recepuysal/kicad-ai-battery-charger/hardware/bom.csv

Reference | Value | Footprint | LCSC | Qty | DNP
C1,C3,C4 | 22uF | LCSC:C0805 | C45783 | 3
C2,C6,C11,C12 | 10uF | LCSC:C0805 | C15850 | 4
C7,C16 | 100nF | LCSC:C0603 | C1591 | 2 | DNP
C8,C9,C10,C14 | 100nF | LCSC:C0603 | C1591 | 4
C15 | 1uF | LCSC:C0603 | C15849 | 1
D1,D2 | SS34 | LCSC:SMA_L4.2-W2.7-LS5.0-RD | C2837271 | 2
D3 | ESDA7P120 | LCSC:SGP1610N2_L1.6-W1.0-P1.1-RD | C2969802 | 1
F1 | 1.1A PTC | LCSC:F2920 | C6044766 | 1
J1 | B8B-XH-A | LCSC:CONN-TH_B8B-XH-A-LF-SN | C157972 | 1
J7 | PİL 3P | LCSC:CONN-TH_3P-P2.50_A2501WV2-3P | C144394 | 1
L2 | 10uH 4.5A | LCSC:IND-SMD_L7.3-W6.8 | C167223 | 1
Q1,Q5 | AO3401A | LCSC:SOT-23_L2.9-W1.3-P1.90-LS2.4-BR | C15127 | 2
Q3 | FS8205A | LCSC:SOT-23-6_L2.9-W1.6-P0.95-LS2.8-BR | C2830320 | 1 | DNP
R1 | 10k | LCSC:R0603 | C25804 | 1
R2,R3 | 5.1k | LCSC:R0603 | C23186 | 2
R4 | 75k | LCSC:R0603 | C23242 | 1
R5 | 100R | LCSC:R0603 | C22775 | 1 | DNP
R6,R11 | 15k | LCSC:R0603 | C22809 | 2
R7,R15,R19 | 100k | LCSC:R0603 | C25803 | 3
R8 | 1k | LCSC:R0603 | C21190 | 1 | DNP
R9 | 1.2k | LCSC:R0603 | C22765 | 1
R16,R17 | 22k | LCSC:R0603 | C31850 | 2
R18 | 6.2k | LCSC:R0603 | C4260 | 1
R20 | 150k | LCSC:R0603 | C22807 | 1
R21,R25 | 0R | LCSC:R0603 | C21189 | 2
R24 | 10k | LCSC:R0603 | C25804 | 1 | DNP
R22,R23 | 4.7k | LCSC:R0603 | C23162 | 2
SW2 | SS12D10G4 | LCSC:SW-TH_SHOU-HAN_SS12D10G4 | C2887259 | 1
TP1 | VBUS | TestPoint:TestPoint_Pad_D2.0mm |  | 1
TP2 | +5V | TestPoint:TestPoint_Pad_D2.0mm |  | 1
TP3 | +3V3 | TestPoint:TestPoint_Pad_D2.0mm |  | 1
TP4 | GND | TestPoint:TestPoint_Pad_D2.0mm |  | 1
TP5 | BAT+ | TestPoint:TestPoint_Pad_D2.0mm |  | 1
TP6 | PROG | TestPoint:TestPoint_Pad_D2.0mm |  | 1
U1 | MT3608 | LCSC:SOT-23-6_L2.9-W1.6-P0.95-LS2.8-BL | C84817 | 1
U2 | DW01A | LCSC:SOT-23-6_L2.9-W1.6-P0.95-LS2.8-BL | C351410 | 1 | DNP
U3 | MAX17048 | LCSC:TDFN-8_L2.0-W2.0-P0.50-BL-EP1.2 | C2682616 | 1
U6 | TP4056 | LCSC:ESOP-8_L4.9-W3.9-P1.27-LS6.0-BL-EP | C725790 | 1
U9 | AP2112K-3.3 | LCSC:SOT-25-5_L2.9-W1.6-P0.95-LS2.8-BL | C51118 | 1
USB1 | TYPE-C 6P | LCSC:TYPE-C-SMD_TYPE-C-6P-073 | C668623 | 1
