recepuysal/kicad-ai-battery-charger/docs/schematic.pdf

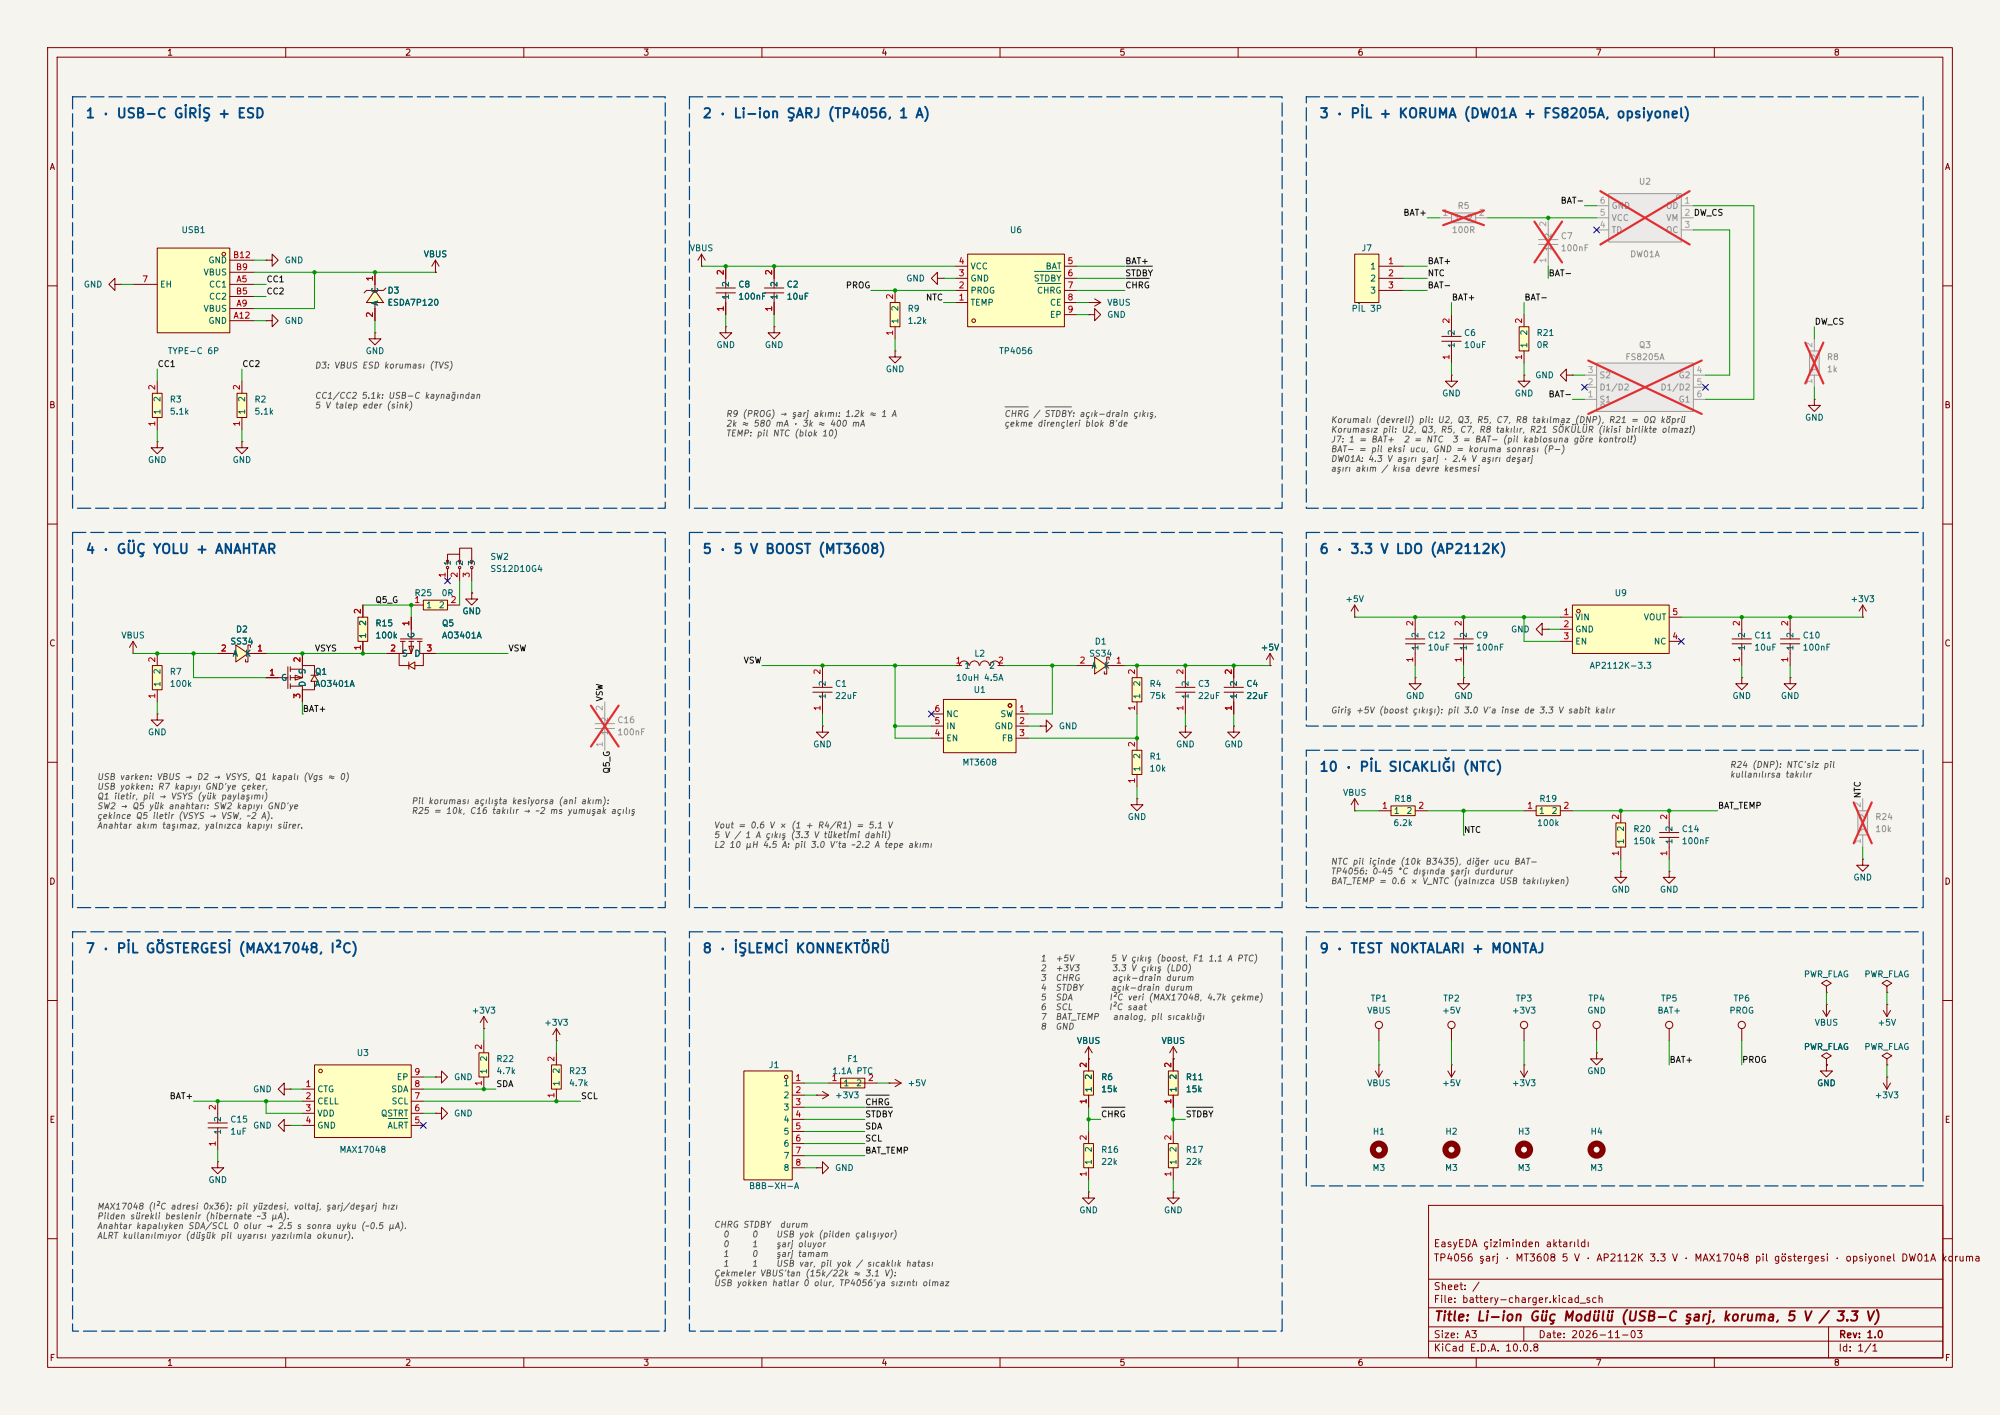
[picture p2: page 1]

CHRG / STDBY: açık-drain çıkış,

Giriş +5V (boost çıkışı): pil 3.0 V'a inse de 3.3 V sabit kalır Korumalı (devreli) pil: U2, Q3, R5, C7, R8 takılmaz (DNP), R21 = 0Ω köprü Korumasız pil: U2, Q3, R5, C7, R8 takılır, R21 SÖKÜLÜR (ikisi birlikte olmaz!) J7: 1 = BAT+ 2 = NTC 3 = BAT− (pil kablosuna göre kontrol!) BAT- = pil eksi ucu, GND = koruma sonrası (P-) DW01A: 4.3 V aşırı şarj · 2.4 V aşırı deşarj aşırı akım / kısa devre kesmesi

TEMP: pil NTC (blok 10)

USB varken: VBUS → D2 → VSYS, Q1 kapalı (Vgs ≈ 0) USB yokken: R7 kapıyı GND'ye çeker, Q1 iletir, pil → VSYS (yük paylaşımı) SW2 → Q5 yük anahtarı: SW2 kapıyı GND'ye

R24 (DNP): NTC'siz pil kullanılırsa takılır 8 · İŞLEMCİ KONNEKTÖRÜ

Vout = 0.6 V × (1 + R4/R1) = 5.1 V 5 V / 1 A çıkış (3.3 V tüketimi dahil) L2 10 µH 4.5 A: pil 3.0 V'ta ~2.2 A tepe akımı Pil koruması açılışta kesiyorsa (ani akım): R25 = 10k, C16 takılır → ~2 ms yumuşak açılış

çekince Q5 iletir (VSYS → VSW, ~2 A). Anahtar akım taşımaz, yalnızca kapıyı sürer.

NTC pil içinde (10k B3435), diğer ucu BAT−
TP4056: 0–45 °C dışında şarjı durdurur BAT_TEMP = 0.6 × V_NTC (yalnızca USB takılıyken)

MAX17048 (I²C adresi 0x36): pil yüzdesi, voltaj, şarj/deşarj hızı Pilden sürekli beslenir (hibernate ~3 µA). Anahtar kapalıyken SDA/SCL 0 olur → 2.5 s sonra uyku (~0.5 µA). ALRT kullanılmıyor (düşük pil uyarısı yazılımla okunur).

TP4056 şarj · MT3608 5 V · AP2112K 3.3 V · MAX17048 pil göstergesi · opsiyonel DW01A koruma

Sheet: /
File: battery-charger.kicad_sch
Title: Li-ion Güç Modülü (USB-C şarj, koruma, 5 V / 3.3 V)

Size: A3 | Rev: 1.0 | F Date: 2026-11-03
KiCad E.D.A. 10.0.8 | Id: 1/1
