recepuysal/kicad-ai-battery-charger/hardware/battery-charger.kicad_sch

## KiCad design hardware/battery-charger.kicad_sch (2026-11-03)

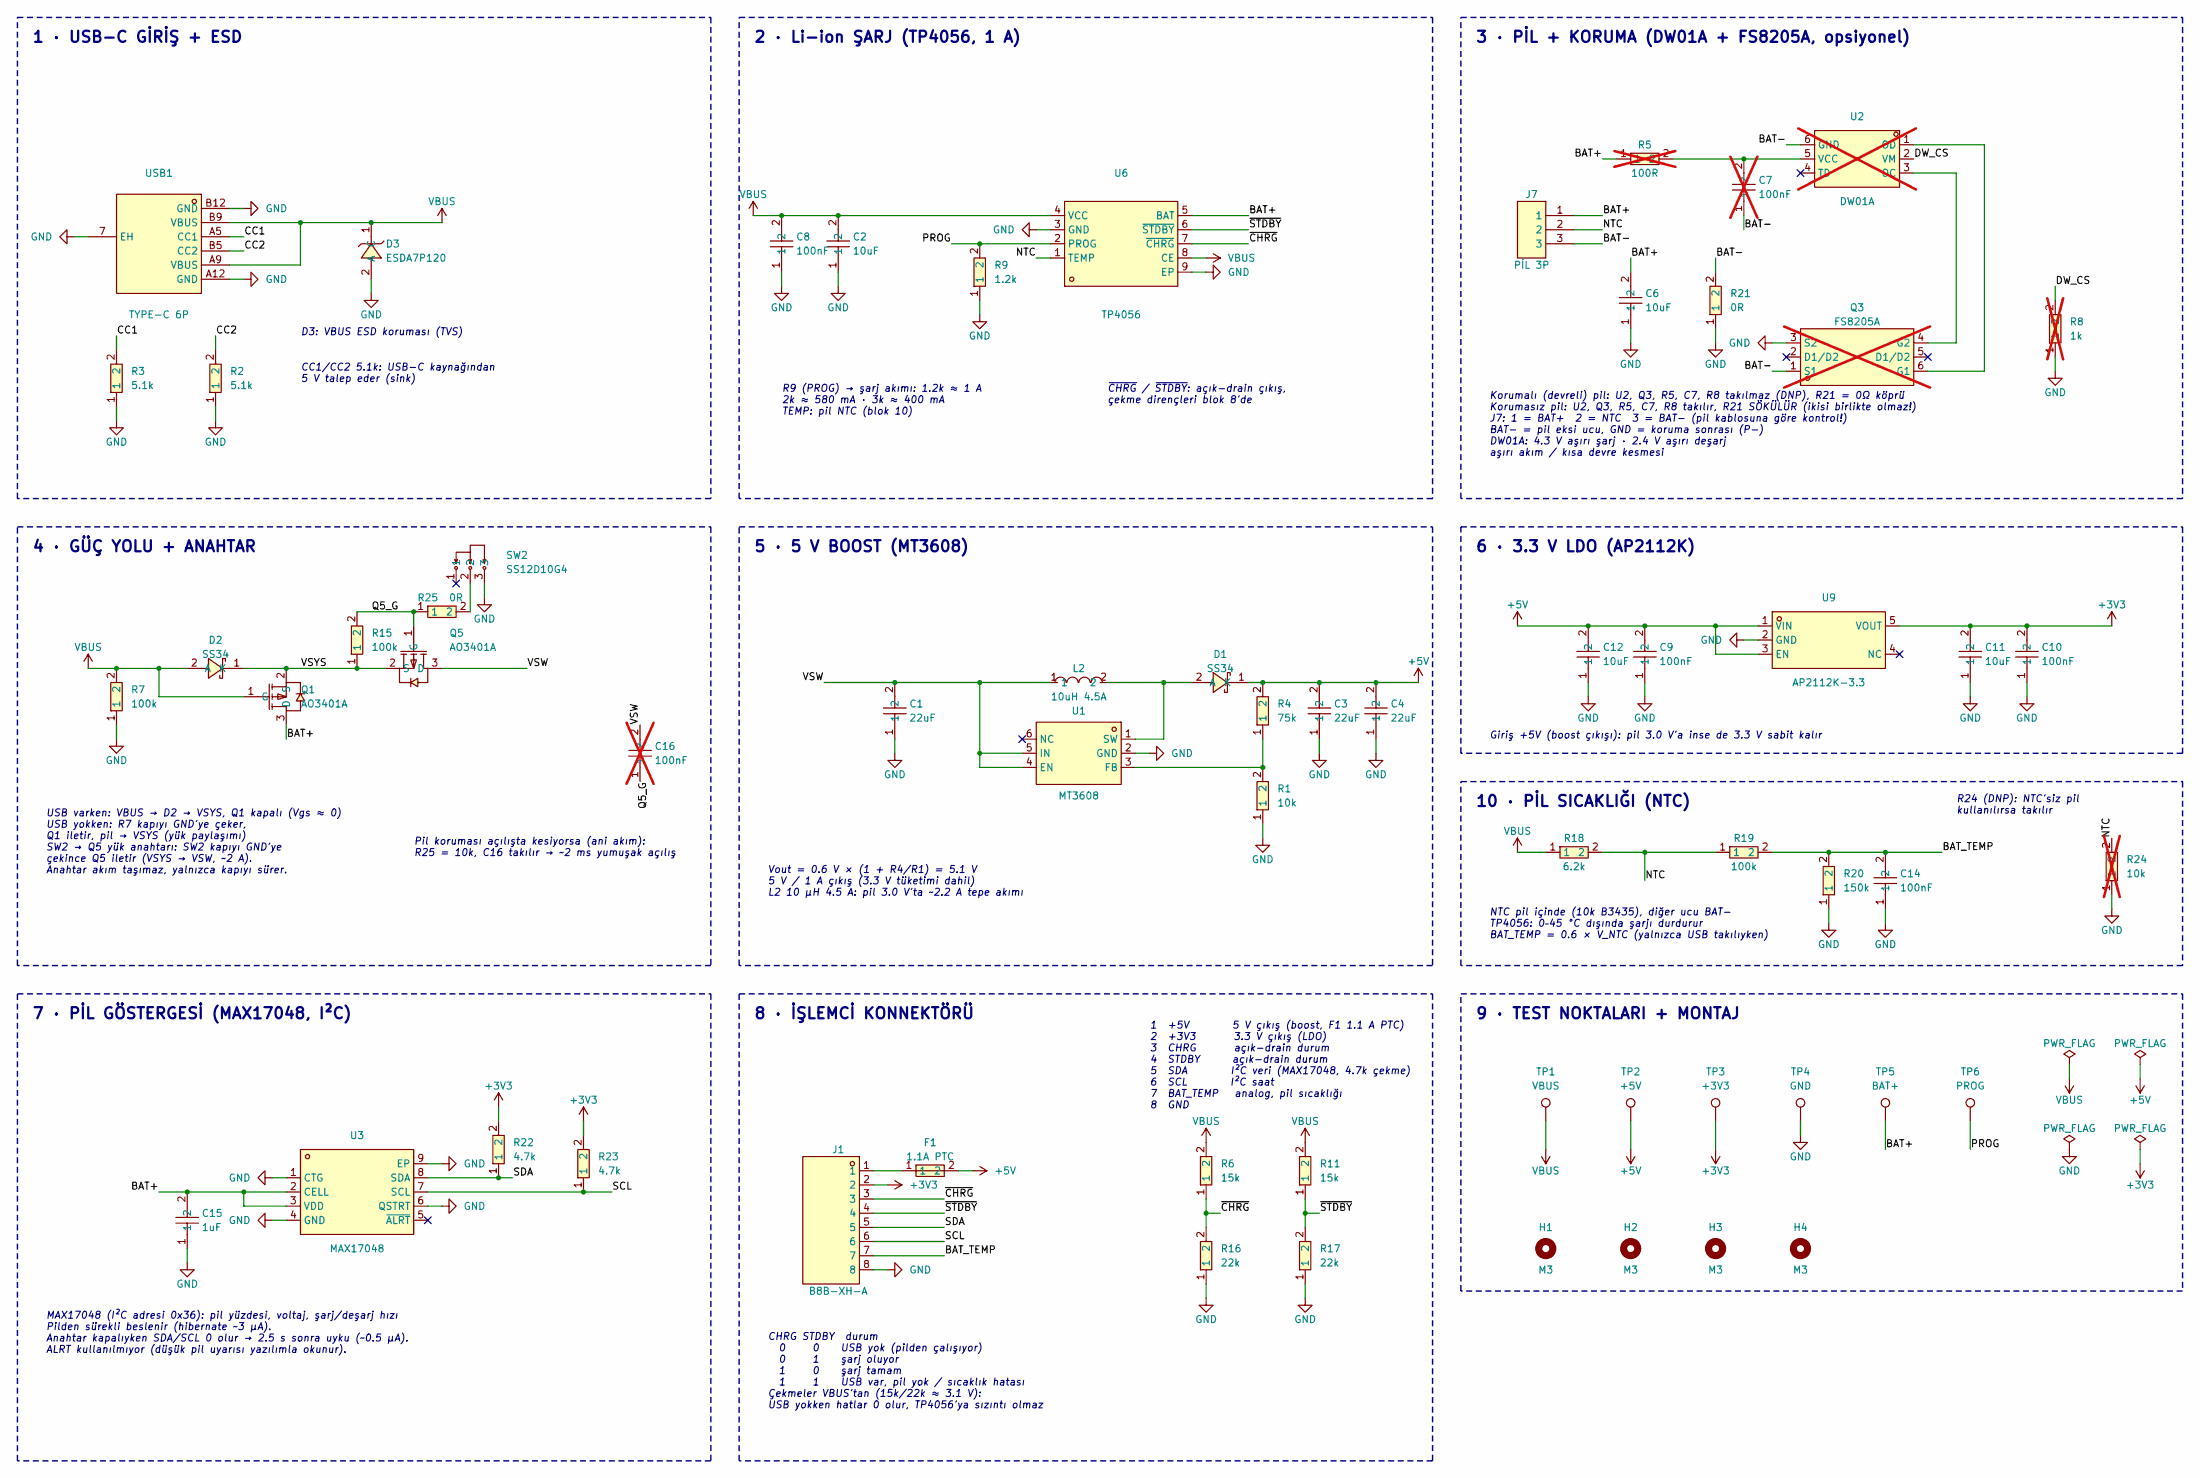
[picture p3: schematic battery-charger.kicad_sch]

Parts:
C1, C3, C4: 22uF; C0805; MPN CL21A226MAQNNNE; LCSC Part C45783
C2, C6, C11, C12: 10uF; C0805; MPN CL21A106KAYNNNE; LCSC Part C15850
C7, C16: 100nF; C0603; MPN CL10B104KB8NNNC; LCSC Part C1591; not fitted
C8, C9, C10, C14: 100nF; C0603; MPN CL10B104KB8NNNC; LCSC Part C1591
C15: 1uF; C0603; MPN CL10A105KB8NNNC; LCSC Part C15849
D1, D2: SS34; SMA_L4.2-W2.7-LS5.0-RD; MPN SS34; LCSC Part C2837271
D3: ESDA7P120; SGP1610N2_L1.6-W1.0-P1.1-RD; MPN ESDA7P120-1U1M; LCSC Part C2969802
F1: 1.1A PTC; F2920; MPN FSMD100-2920-R; LCSC Part C6044766
H1, H2, H3, H4: M3; MountingHole_3.2mm_M3
J1: B8B-XH-A; CONN-TH_B8B-XH-A-LF-SN; MPN B8B-XH-A(LF)(SN); LCSC Part C157972
J7: PİL 3P; CONN-TH_3P-P2.50_A2501WV2-3P; MPN B3B-XH-A(LF)(SN); LCSC Part C144394
L2: 10uH 4.5A; IND-SMD_L7.3-W6.8; MPN FXL0630-100-M; LCSC Part C167223
Q1, Q5: AO3401A; SOT-23_L2.9-W1.3-P1.90-LS2.4-BR; MPN AO3401A; LCSC Part C15127
Q3: FS8205A; SOT-23-6_L2.9-W1.6-P0.95-LS2.8-BR; MPN FS8205A; LCSC Part C2830320; not fitted
R1: 10k; R0603; MPN 0603WAF1002T5E; LCSC Part C25804
R2, R3: 5.1k; R0603; MPN 0603WAF5101T5E; LCSC Part C23186
R4: 75k; R0603; MPN 0603WAF7502T5E; LCSC Part C23242
R5: 100R; R0603; MPN 0603WAF1000T5E; LCSC Part C22775; not fitted
R6, R11: 15k; R0603; MPN 0603WAF1502T5E; LCSC Part C22809
R7, R15, R19: 100k; R0603; MPN 0603WAF1003T5E; LCSC Part C25803
R8: 1k; R0603; MPN 0603WAF1001T5E; LCSC Part C21190; not fitted
R9: 1.2k; R0603; MPN 0603WAF1201T5E; LCSC Part C22765
R16, R17: 22k; R0603; MPN 0603WAF2202T5E; LCSC Part C31850
R18: 6.2k; R0603; MPN 0603WAF6201T5E; LCSC Part C4260
R20: 150k; R0603; MPN 0603WAF1503T5E; LCSC Part C22807
R21, R25: 0R; R0603; MPN 0603WAF0000T5E; LCSC Part C21189
R22, R23: 4.7k; R0603; MPN 0603WAF4701T5E; LCSC Part C23162
R24: 10k; R0603; MPN 0603WAF1002T5E; LCSC Part C25804; not fitted
SW2: SS12D10G4; SW-TH_SHOU-HAN_SS12D10G4; MPN SS12D10G4 071; LCSC Part C2887259
TP1: VBUS; TestPoint_Pad_D2.0mm
TP2: +5V; TestPoint_Pad_D2.0mm
TP3: +3V3; TestPoint_Pad_D2.0mm
TP4: GND; TestPoint_Pad_D2.0mm
TP5: BAT+; TestPoint_Pad_D2.0mm
TP6: PROG; TestPoint_Pad_D2.0mm
U1: MT3608; SOT-23-6_L2.9-W1.6-P0.95-LS2.8-BL; MPN MT3608; LCSC Part C84817
U2: DW01A; SOT-23-6_L2.9-W1.6-P0.95-LS2.8-BL; MPN DW01A; LCSC Part C351410; not fitted
U3: MAX17048; TDFN-8_L2.0-W2.0-P0.50-BL-EP1.2; MPN MAX17048G+T10; LCSC Part C2682616
U6: TP4056; ESOP-8_L4.9-W3.9-P1.27-LS6.0-BL-EP; MPN TP4056; LCSC Part C725790
U9: AP2112K-3.3; SOT-25-5_L2.9-W1.6-P0.95-LS2.8-BL; MPN AP2112K-3.3TRG1; LCSC Part C51118
USB1: TYPE-C 6P; TYPE-C-SMD_TYPE-C-6P-073; MPN TYPE-C 6P(073); LCSC Part C668623

Connections:
+3V3: C10.2, C11.2, J1.2, R22.2, R23.2, TP3.1, U9.5 (VOUT)
+5V: C3.2, C4.2, C9.2, C12.2, D1.1 (K), F1.2, R4.2, TP2.1, U9.1 (VIN), U9.3 (EN)
BAT+: C6.2, C15.2, J7.1, Q1.3 (D), R5.1, TP5.1, U3.2 (CELL), U3.3 (VDD), U6.5 (BAT)
BAT-: C7.1, J7.3, Q3.1 (S1), R21.2, U2.6 (GND)
BAT_TEMP: C14.2, J1.7, R19.2, R20.2
CC1: R3.2, USB1.A5 (CC1)
CC2: R2.2, USB1.B5 (CC2)
DW_CS: R8.2, U2.2 (VM)
GND: C1.1, C2.1, C3.1, C4.1, C6.1, C8.1, C9.1, C10.1, C11.1, C12.1, C14.1, C15.1, D3.2 (A), J1.8, Q3.3 (S2), R1.1, R2.1, R3.1, R7.1, R8.1, R9.1, R16.1, R17.1, R20.1, R21.1, R24.1, SW2.3, TP4.1, U1.2 (GND), U3.1 (CTG), U3.4 (GND), U3.6 (QSTRT), U3.9 (EP), U6.3 (GND), U6.9 (EP), U9.2 (GND), USB1.7 (EH), USB1.A12 (GND), USB1.B12 (GND)
NTC: J7.2, R18.2, R19.1, R24.2, U6.1 (TEMP)
unnamed: C7.2, R5.2, U2.5 (VCC)
unnamed: D1.2 (A), L2.2, U1.1 (SW)
unnamed: F1.1, J1.1
unnamed: Q3.4 (G2), U2.3 (OC)
unnamed: Q3.6 (G1), U2.1 (OD)
unnamed: R1.2, R4.1, U1.3 (FB)
unnamed: R25.2, SW2.2
PROG: R9.2, TP6.1, U6.2 (PROG)
Q5_G: C16.1, Q5.1 (G), R15.2, R25.1
SCL: J1.6, R23.1, U3.7 (SCL)
SDA: J1.5, R22.1, U3.8 (SDA)
VBUS: C2.2, C8.2, D2.2 (A), D3.1 (C), Q1.1 (G), R6.2, R7.2, R11.2, R18.1, TP1.1, U6.4 (VCC), U6.8 (CE), USB1.A9 (VBUS), USB1.B9 (VBUS)
VSW: C1.2, C16.2, L2.1, Q5.3 (D), U1.4 (EN), U1.5 (IN)
VSYS: D2.1 (K), Q1.2 (S), Q5.2 (S), R15.1
~CHRG: J1.3, R6.1, R16.2, U6.7 (~CHRG)
~STDBY: J1.4, R11.1, R17.2, U6.6 (~STDBY)

Notes on the sheet:
1 · USB-C GİRİŞ + ESD
CC1/CC2 5.1k: USB-C kaynağından 5 V talep eder (sink)
D3: VBUS ESD koruması (TVS)
2 · Li-ion ŞARJ (TP4056, 1 A)
R9 (PROG) → şarj akımı: 1.2k ≈ 1 A 2k ≈ 580 mA · 3k ≈ 400 mA TEMP: pil NTC (blok 10)
~{CHRG} / ~{STDBY}: açık-drain çıkış, çekme dirençleri blok 8'de
3 · PİL + KORUMA (DW01A + FS8205A, opsiyonel)
Korumalı (devreli) pil: U2, Q3, R5, C7, R8 takılmaz (DNP), R21 = 0Ω köprü Korumasız pil: U2, Q3, R5, C7, R8 takılır, R21 SÖKÜLÜR (ikisi birlikte olmaz!) J7: 1 = BAT+ 2 = NTC 3 = BAT− (pil kablosuna göre kontrol!) BAT- = pil eksi ucu, GND = koruma sonrası (P-) DW01A: 4.3 V aşırı şarj · 2.4 V aşırı d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
4 · GÜÇ YOLU + ANAHTAR
USB varken: VBUS → D2 → VSYS, Q1 kapalı (Vgs ≈ 0) USB yokken: R7 kapıyı GND'ye çeker, Q1 iletir, pil → VSYS (yük paylaşımı) SW2 → Q5 yük anahtarı: SW2 kapıyı GND'ye çekince Q5 iletir (VSYS → VSW, ~2 A). Anahtar akım taşımaz, yalnızca kapıyı sürer.
5 · 5 V BOOST (MT3608)
Vout = 0.6 V × (1 + R4/R1) = 5.1 V 5 V / 1 A çıkış (3.3 V tüketimi dahil) L2 10 µH 4.5 A: pil 3.0 V'ta ~2.2 A tepe akımı
6 · 3.3 V LDO (AP2112K)
Giriş +5V (boost çıkışı): pil 3.0 V'a inse de 3.3 V sabit kalır
10 · PİL SICAKLIĞI (NTC)
NTC pil içinde (10k B3435), diğer ucu BAT− TP4056: 0–45 °C dışında şarjı durdurur BAT_TEMP = 0.6 × V_NTC (yalnızca USB takılıyken)
7 · PİL GÖSTERGESİ (MAX17048, I²C)
MAX17048 (I²C adresi 0x36): pil yüzdesi, voltaj, şarj/deşarj hızı Pilden sürekli beslenir (hibernate ~3 µA). Anahtar kapalıyken SDA/SCL 0 olur → 2.5 s sonra uyku (~0.5 µA). ALRT kullanılmıyor (düşük pil uyarısı yazılımla okunur).
8 · İŞLEMCİ KONNEKTÖRÜ
1 +5V 5 V çıkış (boost, F1 1.1 A PTC) 2 +3V3 3.3 V çıkış (LDO) 3 CHRG açık-drain durum 4 STDBY açık-drain durum 5 SDA I²C veri (MAX17048, 4.7k çekme) 6 SCL I²C saat 7 BAT_TEMP analog, pil sıcaklığı 8 GND
CHRG STDBY durum 0 0 USB yok (pilden çalışıyor) 0 1 şarj oluyor 1 0 şarj tamam 1 1 USB var, pil yok / sıcaklık hatası Çekmeler VBUS'tan (15k/22k ≈ 3.1 V): USB yokken hatlar 0 olur, TP4056'ya sızıntı olmaz
9 · TEST NOKTALARI + MONTAJ
R24 (DNP): NTC'siz pil kullanılırsa takılır
Pil koruması açılışta kesiyorsa (ani akım): R25 = 10k, C16 takılır → ~2 ms yumuşak açılış
