recepuysal/kicad-ai-battery-charger/(commit log)

2026-11-03 Li-ion power module schematic drawn with AI in KiCad 10
    USB-C charging (TP4056, 1 A), DW01A + FS8205A protection, load sharing,
    MOSFET load switch, MT3608 5 V / 1 A boost, AP2112K 3.3 V LDO, switched
    battery voltage measurement, battery NTC and an 8-pin MCU connector.
    Project-local symbol/footprint/3D library, BOM with LCSC part numbers,
    PDF/PNG schematic and the generator + netlist verification scripts.
    [battery-charger.kicad_sch, bom.csv]
2026-11-03 Add 5 V output PTC fuse, make on-board battery protection optional
    - F1: 1.1 A resettable PTC (FSMD100-2920) on the MCU connector 5 V pin
    - DW01A/FS8205A protection (U2, Q3, R5, C7, R8) marked DNP for packs with
    their own protection; R21 0R bridges BAT- to GND (fit one or the other)
    - BOM gains a DNP column; docs and README updated
    [battery-charger.kicad_sch, bom.csv]
2026-11-03 Replace divider battery measurement with MAX17048 fuel gauge
    - U3 MAX17048 (C2682616) on the battery, 1 uF VDD bypass, 4.7 k I2C pull-ups
    - Removes the switched voltage divider (Q2, Q4, R10, R12-R14, C13)
    - MCU connector stays 8-pin: pins 5/6 are now SDA/SCL
    - README: fuel gauge, firmware notes (sleep behaviour, 3.3 V cutoff)
    - build script removes footprints/3D models that are no longer used
    [battery-charger.kicad_sch, bom.csv]
2026-11-03 Add no-NTC option, load-switch soft-start option, review notes
    - R24 (10k, DNP) from NTC to GND: fit for 2-wire packs, otherwise the
    TP4056 sees a temperature fault and never charges.
    - R25 (0R) in series with the SW2 -> Q5 gate line and C16 (100nF, DNP)
    from Q5 gate to VSW: optional soft start if the pack protection trips
    on switch-on inrush. Default build is electrically unchanged.
    - verify_netlist.py, BOM, schematic PDF/PNG updated.
    - README (EN/TR): clarify what the netlist check proves; notes on
    TP4056 dissipation, PTC derating, BAT_TEMP accuracy, MCU back-feed
    and D2 leakage in the off state.
    [battery-charger.kicad_sch, bom.csv]
